domoritz/S76D/docs/src/render.png

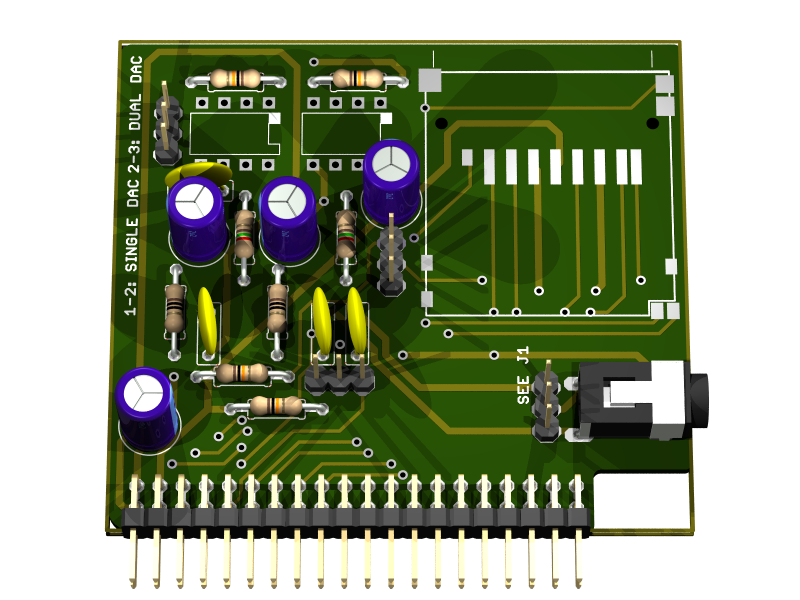
docs/src/render.png
