domoritz/S76D/docs/HighLevelOverview.pdf

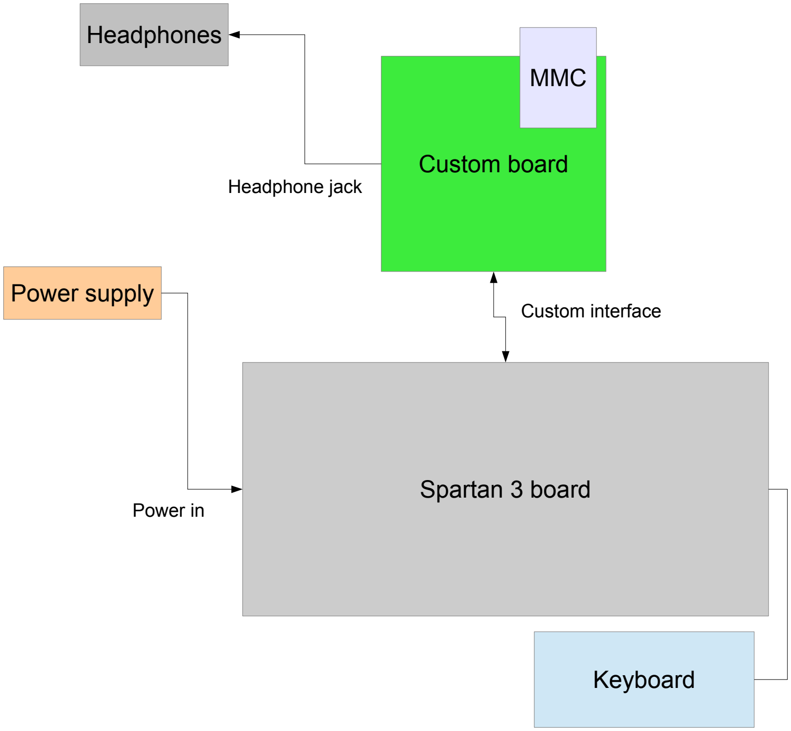
[picture p3: figure]
Spartan 3 board; Custom board; Headphones; MMC; Power supply; Keyboard; Custom interface; Headphone jack; Power in

PS/2
