domoritz/S76D/docs/doc.pdf

# Singing Very High Speed Integrated Circuit Hardware Description Language Board (S76D)

### Kai Fabian Hasso-Plattner-Institut Potsdam

### Dominik Moritz Hasso-Plattner-Institut Potsdam

### May 12, 2013


Figure 1: 3D rendered image of the custom extension board used for this music player

Abstract
A VHDL implementation of the MMC SPI interface . . .

## Contents

1 Introduction | 2
2 Multimedia Card | 2

## 1 Introduction

## 2 Multimedia Card

### 2.1 Interface description

Figure 2 shows an MMC card and Table 1 describes the pins of the MMC card.

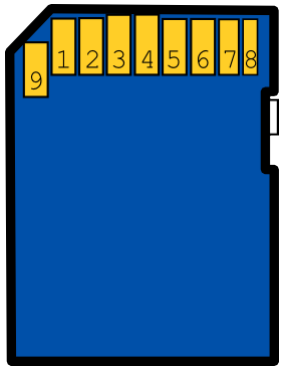
[picture p4: figure]

Figure 2: MMC Interface

Pin. No. | Name | Description | Note for our implementation
1 2 3 4 5 6 7 8 9 | DAT3 CMD GND VDD CLK GND DAT0 DAT1 DAT2 | MMC: Chip select Command Ground Voltage Clock Ground Data Data Data | Chip IO Pin, mmc cs, D7 Chip IO Pin, mmc mosi, D8, (MOSI – mas-ter out, slave in) Board ground Supply Voltage (+3.3 V) Chip IO Pin, mmc clock, D10 Board ground Chip IO, mmc miso, B4, (MISO - master in, slave out) Pull up (Voltage via resistor) Pull up (Voltage via resistor)

Table 1: MMC card pin description

### 2.2 SPI Interface

The SPI Interface uses two connections to the MMC. First the master out, slave in to send commands to the MMC and the master in, slave out to receive the results from the MMC. You can see the pins on the MMC in figure 2.

Sending commands requires you to stick to a predefined protocol that we will describe. A basic sequence for one command can be found in Figure 3. In Figure 4 and 5 you can find the sequence of commands we have to send to the card in order to initialize it or read a block.

### MISO

### MOSI Command 6 Byte = 48 Bit

### RT=Response Token

RT

### SB=Start Byte

SB | Data Block | CRC
1 Byte | 1 Byte | 512 Byte | 2 Byte

### CRC = Cyclic Redundancy Check

Figure 3: Sending a command to the MMC

Each command is a binary coded sequence in a format that is defined in the official reference manual. Figure 3 should give you a basic idea of how the communication works. The start byte (SB) consists of 8 times HI (1). Before that, the card only sends 0s. The response token (RT) consists of 8 bits. Each bit indicates a certain error or a successful command. In case the command finished successfully, the card returns 0000 0001.

### 2.2.1 Initializing the card

The MMC cards needs to be initialized before it can be used to read data. According to the specs, one need to send a CMD0 and CMD1 after at least 74 clock cycles to synchronize the card clock. The initialization process is complete when the card responds with 0000 0000 (busy) instead of 0000 0001 (ready).

The whole initialization procedure is shown in Figure 4.

### 2.2.2 Reading data

Reading from the MMC card is shown in Figure 5. The command CMD17 to reads 1 block of data from the MMC card starting at the address specified in the argument field. The size of the block that is read has to be defined with a command CMD16 (which is not shown here).

### 2.3 Implementation of Communication

Figure 6 shows the finite state machine of our implementation in VHDL. {n} means that the number preceding the brackets is repeated n times.

### 2.4 Most important MMC SPI commands

Table 2 shows the most important command that we used in our implementation.

More details about the SPI commands, responses and timings can be found in the MMC specification.

## List of Figures

1 | 3D rendered image of the custom extension board used for this music player | | 1

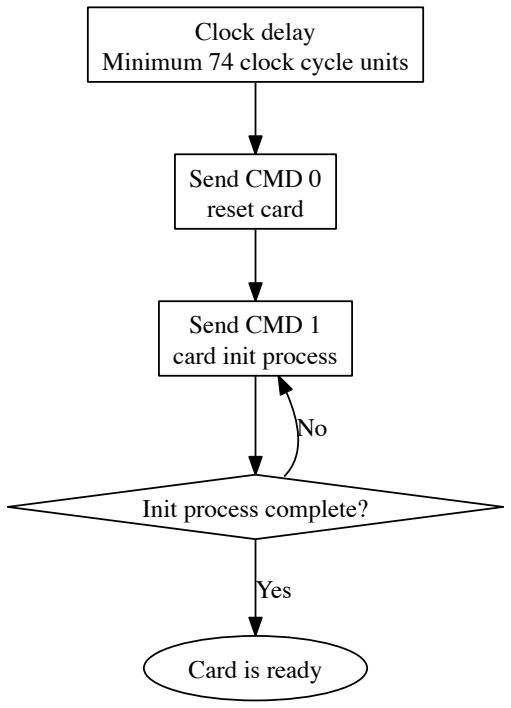
[picture p5: figure]
Clock delay Minimum 74 clock cycle units; Send CMD 0 reset card; Send CMD 1 card init process; Init process complete?; Card is ready; Yes

Figure 4: Flow for initializing

2 | MMC Interface | | 2
3 | Sending a command to the MMC | | 3
4 | Flow for initializing | | 4
5 | Flow for reading | | 5
6 | Controller VHDL FSM | | 6

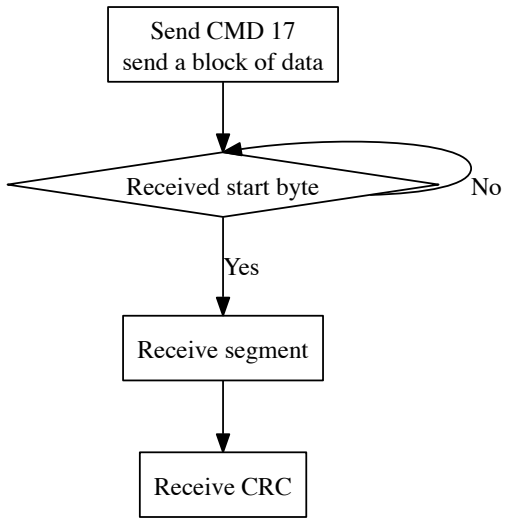
[picture p6: figure]
Send CMD 17 send a block of data; Received start byte; Receive segment; Receive CRC; Yes

Figure 5: Flow for reading

Command | Name | Description
CMD0 CMD1 CMD16 CMD17 | GO IDLE STATE SEND OP COND SET BLOCKLEN READ SINGLE BLOCK | Reset the card. If CS == 0, the card goes into SPI mode. initialize the card. The command has to be sent repeatedly until the response changes from 0000 0000 (busy) to 0000 0001 (ready). Set the block size. Send the block size as the argument. Read one block as specified in CMD16. Send the start address as the argument.

Table 2: MMC SPI commands used in this implementation.

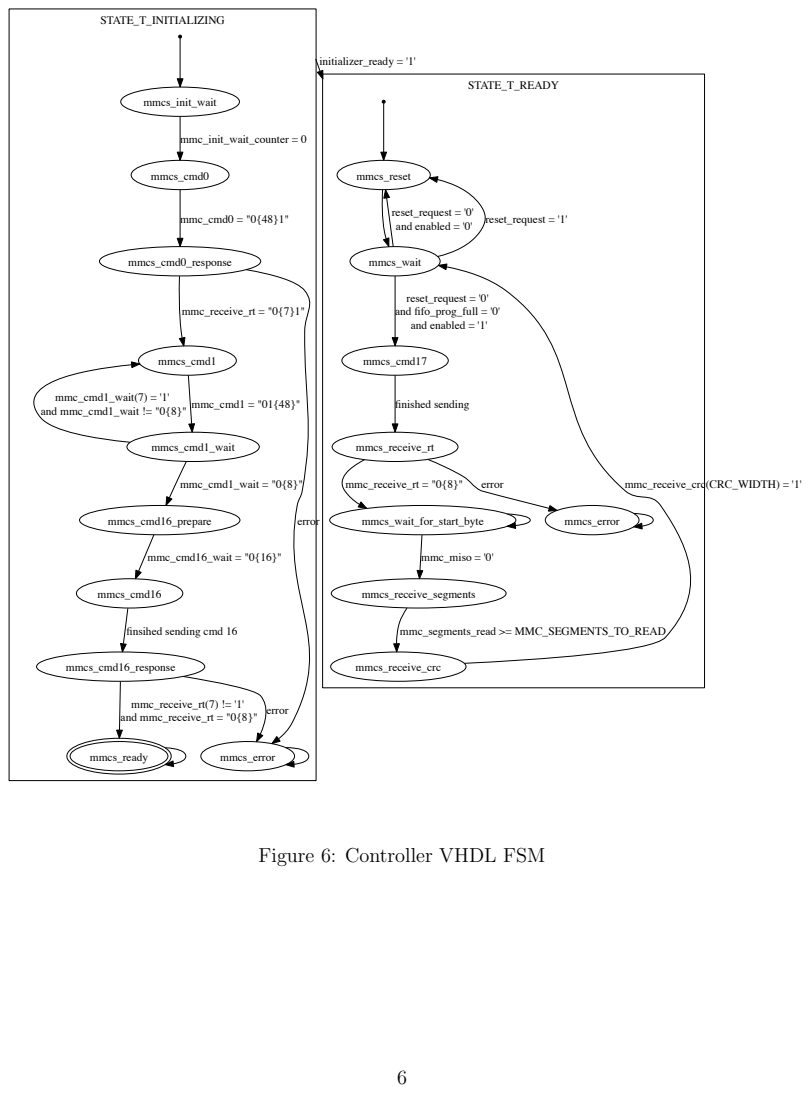
[picture p7: page 6]
STATE_T_INITIALIZING; STATE_T_READY; mmcs_init_wait; mmcs_reset; mmcs_ready; initializer_ready = '1'; mmcs_error; mmcs_cmd0; mmc_init_wait_counter = 0; mmcs_cmd0_response; mmc_cmd0 = "0{48}1"; mmcs_cmd1; mmc_receive_rt = "0{7}1"; error; mmcs_cmd1_wait; mmc_cmd1 = "01{48}"; mmcs_cmd16_prepare; mmc_cmd1_wait = "0{8}"; mmc_cmd1_wait(7) = '1' and mmc_cmd1_wait != "0{8}"; mmcs_cmd16; mmc_cmd16_wait = "0{16}"; mmcs_cmd16_response; mmc_receive_rt(7) != '1' and mmc_receive_rt = "0{8}" error; mmcs_wait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

finsihed sending cmd 16

Figure 6: Controller VHDL FSM
