domoritz/S76D/docs/flow_read_mmc.pdf

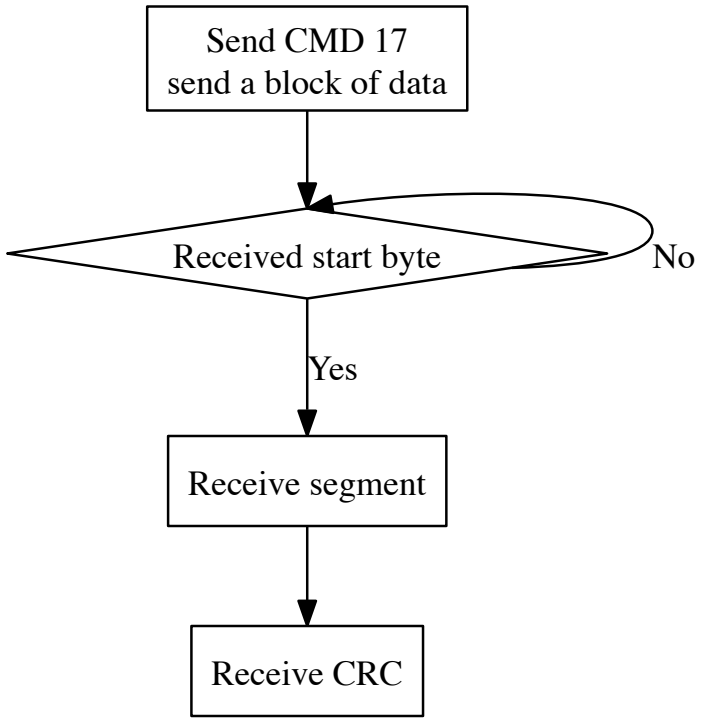
[picture p8: figure]
Send CMD 17 send a block of data; Received start byte; Receive segment; Receive CRC; Yes
