domoritz/S76D/schematics/images/board.png

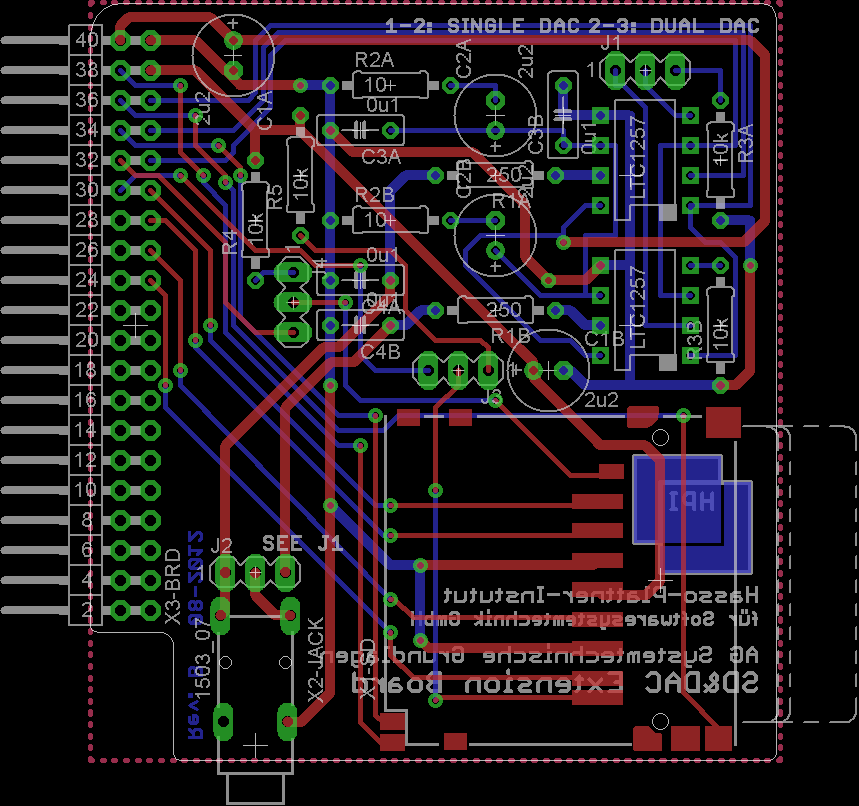
schematics/images/board.png
