domoritz/S76D/schematics/images/schematic.png

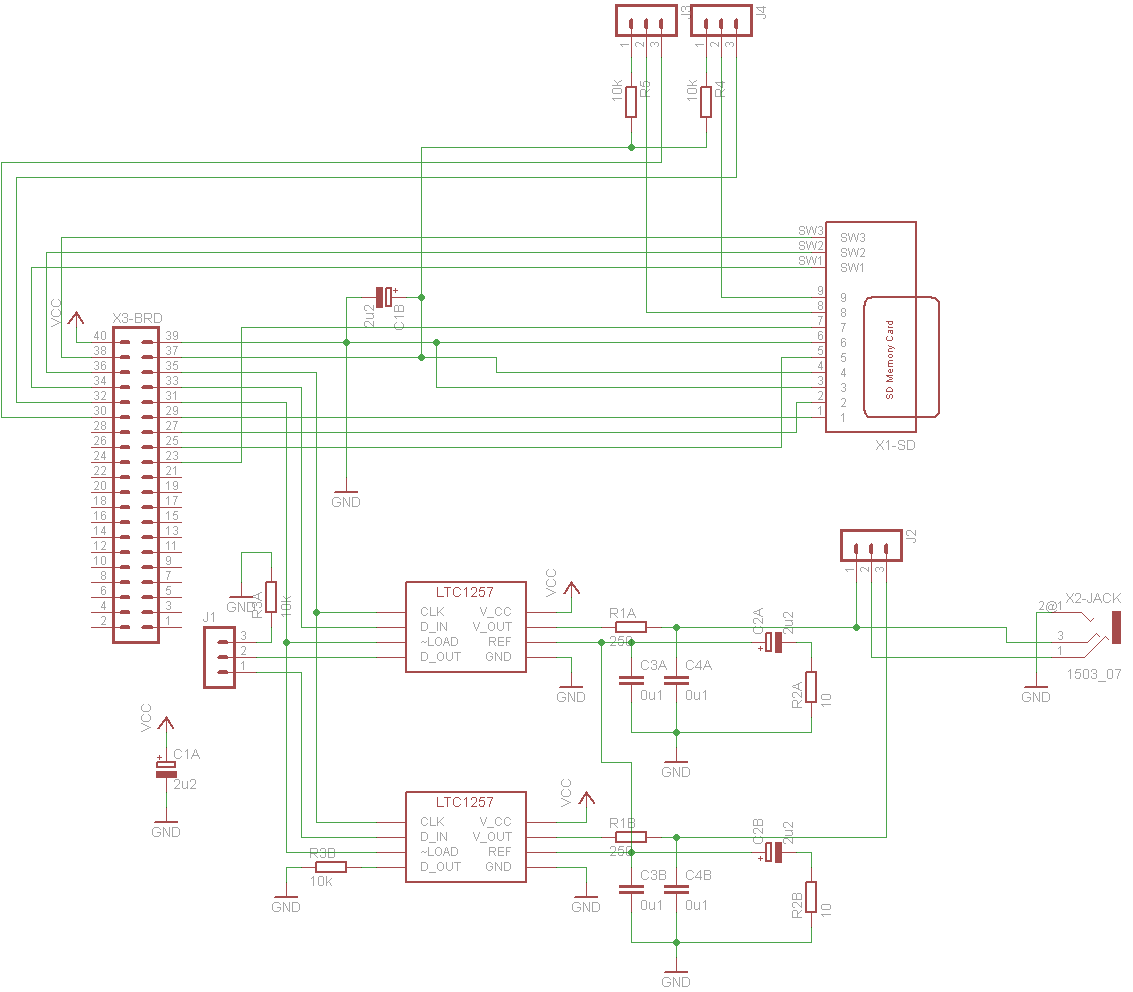
schematics/images/schematic.png
