domoritz/S76D/schematics/extboard.brd

## EAGLE design schematics/extboard.brd (2012-08-01)

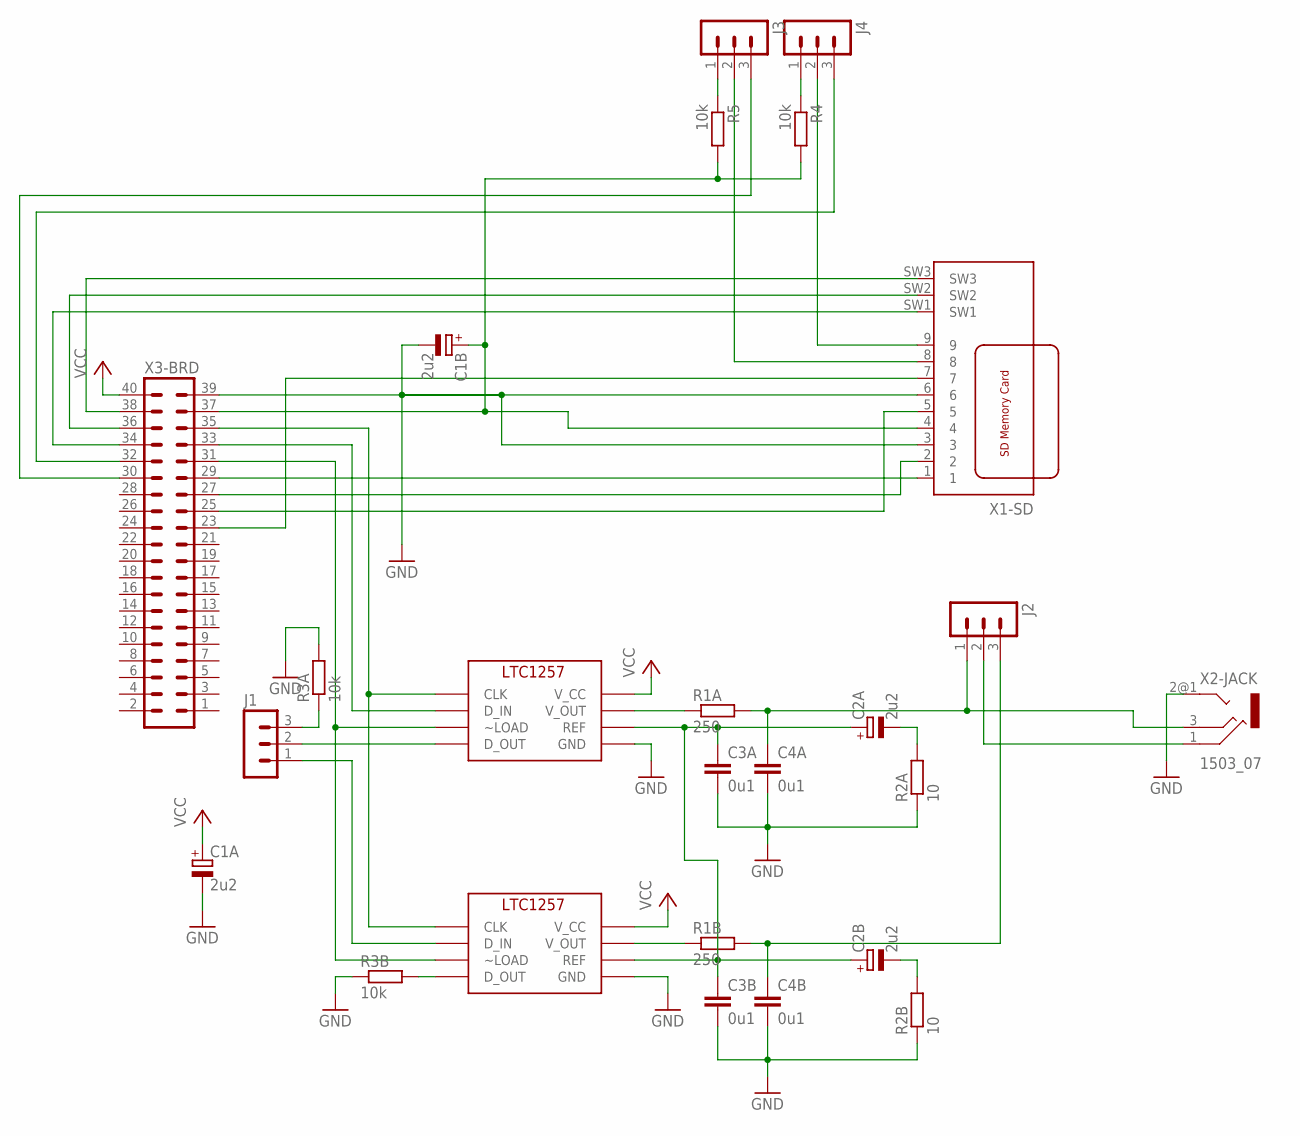
[picture p11: schematic extboard.sch]

Parts:
C1A, C1B, C2A, C2B: 2u2; E2,5-7
C3A, C3B, C4A, C4B: 0u1; C050-025X075
J1, J2, J3, J4: MA03-1
R1A, R1B: 250; 0207/10
R2A, R2B: 10; 0207/10
R3A, R3B, R4, R5: 10k; 0207/10
U1, U2: LTC1257; DIL-8
X1-SD: SDBMF; SDBMF-009XXBXX2
X2-JACK: 1503_07
X3-BRD: MA20-2W

Connections:
GND: C1A.-, C1B.-, C3A.2, C3B.2, C4A.2, C4B.2, R2A.1, R2B.1, R3A.2, R3B.1, U1.P$5 (GND), U2.P$5 (GND), X1-SD.3, X1-SD.6, X2-JACK.2@1 (2), X3-BRD.39
unnamed: U1.P$1 (CLK), U2.P$1 (CLK), X3-BRD.35
unnamed: U1.P$2 (D_IN), X3-BRD.33
unnamed: U1.P$3 (~LOAD), U2.P$3 (~LOAD), X3-BRD.31
unnamed: J1.1, U2.P$2 (D_IN)
unnamed: C2A.-, R2A.2
unnamed: C2A.+, C2B.+, C3A.1, C3B.1, U1.P$6 (REF), U2.P$6 (REF)
unnamed: C4A.1, J2.1, R1A.2, X2-JACK.3
unnamed: R1A.1, U1.P$7 (V_OUT)
unnamed: C1B.+, R4.2, R5.2, X1-SD.4, X3-BRD.37
unnamed: J3.1, R5.1
unnamed: X1-SD.1, X3-BRD.29
unnamed: X1-SD.2, X3-BRD.27
unnamed: X1-SD.5, X3-BRD.25
unnamed: X1-SD.7, X3-BRD.23
unnamed: J1.3, R3A.1
unnamed: J1.2, U1.P$4 (D_OUT)
unnamed: J2.2, X2-JACK.1
unnamed: R3B.2, U2.P$4 (D_OUT)
unnamed: C4B.1, J2.3, R1B.2
unnamed: R1B.1, U2.P$7 (V_OUT)
unnamed: C2B.-, R2B.2
unnamed: X1-SD.SW1, X3-BRD.34
unnamed: X1-SD.SW2, X3-BRD.36
unnamed: X1-SD.SW3, X3-BRD.38
unnamed: J4.1, R4.1
unnamed: J3.2, X1-SD.8
unnamed: J4.2, X1-SD.9
unnamed: J4.3, X3-BRD.32
unnamed: J3.3, X3-BRD.30
VCC: C1A.+, U1.P$8 (V_CC), U2.P$8 (V_CC), X3-BRD.40

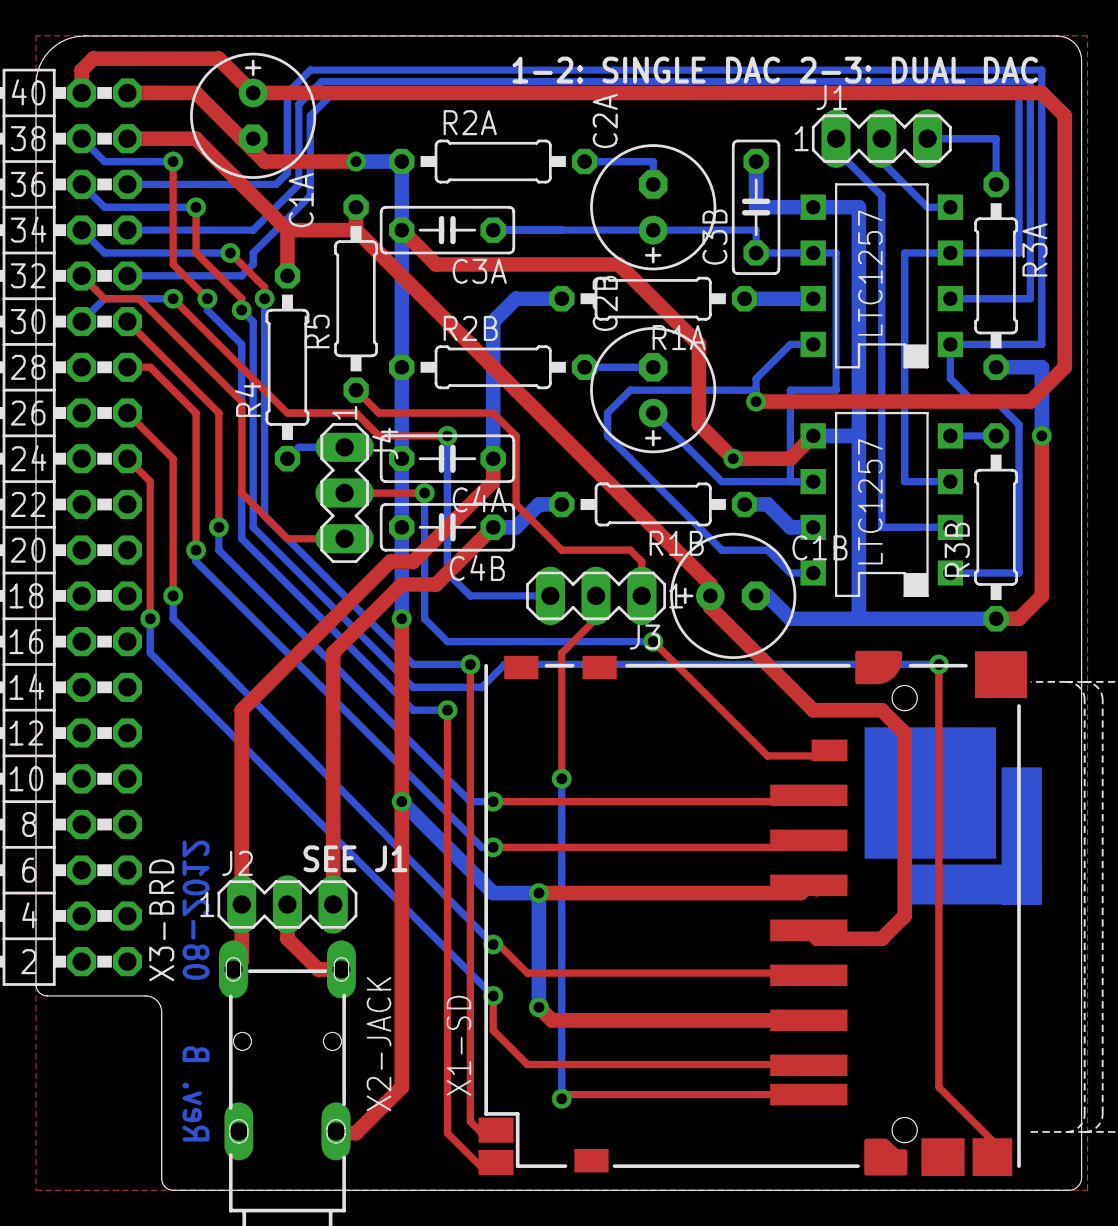
[picture p12: board extboard.brd from above]

Board: 2 copper layers, 58.1 x 64.1 mm, 25 parts (0 on the bottom side), 31 nets.
