domoritz/S76D/(commit log)

2012-05-30 added necessary files for deplyment on spartan board
2012-07-02 Fixed test board name
2012-07-02 schematics: PCB draft
    [extboard.brd, extboard.sch]
2012-07-05 added notes on schematics
2012-07-24 schematics: board rev. A
    [extboard.brd, extboard.sch]
2012-07-24 schematics: Fix in Rev A
    [extboard.brd, extboard.sch]
2012-07-24 schematics: part list for Rev A + partial suppliers
2012-07-24 flow chart for reading
2012-08-01 schematics: next iteration
    [extboard.brd, extboard.sch]
2012-08-01 schematic: Revision A iteration - jumpers for connecting DATA2 and DATA3 to board
    [extboard.brd, extboard.sch]
2012-08-01 schematics: Elevated to Revision B (2 prototypes in production)
    [extboard.brd, extboard.sch]
2012-08-01 schematics: Rev. B images
2012-08-01 schematics: Do not ignore .zip files anymore
2012-08-01 schematics: Revision B production files
2012-08-01 schematics: Added render of Rev. B
2013-05-12 Fix little error in mmc controller flow
